AlexandruGabrielBrabete/3.8V-Li-Ion-Smart-Charger/Smart Battery Charger with Bargraph - LTSpice.asc

Led_Albastru: LED; QTLP690C
Led_Galben: LED; QTLP690C
Led_Rosu: LED; QTLP690C
Led_Verde: LED; QTLP690C
R1: res; 470
R1div1: res; 2k
R1div2: res; 820
R1div3: res; 3.3k
R2: res; 470
R2div1: res; 8.2k
R2div2: res; 4.3k
R2div3: res; 560
R3: res; 470
R3div3: res; 470
R4: res; 470
R4div3: res; 430
R5div3: res; 6.8k
R_bat: res; 3
R_set: res; 1k
Rshunt: res; 1
U1: LT3080
U2: LM339
U3: LM741
U4: AD584
U5: AD8210
U6: LM324
U7: UniversalOpAmp
U8: UniversalOpAmp
U9: LM324
U10: LM324
U11: LM324
V1: voltage; 10
V2: voltage; PULSE(0V 4.199 10m 25000m 100000 30000m 30000m 1)
Named nets: 0, Val, Vref, VTensiune, VCurent, Vbat, Ref_CRITIC, Ref_JOS, Ref_MEDIU, Ref_FULL
.tran 0 35 1m
.ic V(v_bat)=2.9
